CTborg-robot/ROS-CTborg/README.md

# ROS-CTborg
Добрый день уважаемые читатели. 
мы создали робота который состоит из модулей
и настраивается под конкретные ваши задачи
в данной модели мы показываем модуль для
работы с плохо видящими людьми
"CTborg поводырь" который отслеживает препятствия
и объясняет человеку как его обойти.
