CTborg-robot/ROS-CTborg/Список компонентов ROS CTborg.xlsx

Категория | Наименование компонента | Назначение, описание | Ссылка | Количество | Цена |  |  | Итоговая сумма | Примерные сроки доставки
 |  |  |  |  | Цена | Доставка | Итого за штуку
Плата | Плата Raspberry Pi 5 8 ГБ Ram Arm Cortex-A76 Linux | Raspberry pi 5 8gb - это новый и усовершенствованный одноплатный компьютер, идеально подходящий для различных проектов. Этот микрокомпьютер обладает высокой производительностью и множеством улучшений по сравнению с предыдущей версией. | https://aliexpress.ru/item/1005002515949841.html?ysclid=m93stthbfn91280838&sku_id=12000020961528705 | 1 | 9236 | 346 | 9582 | 9582 | 15 дней
Модуль | ESP32 ESP-WROOM-32 | Мощный, универсальный Модуль MCU Wi-Fi + BT + BLE, предназначенный для широкого спектра приложений, Начиная от маломощных сенсорных сетей до самых сложных задач, таких как Как кодирование голоса, потоковая передача музыки и декодирование MP3 | https://aliexpress.ru/item/1005002515949841.html?ysclid=m93stthbfn91280838&sku_id=12000020961528705 | 1 | 319 | 83 | 402 | 402 | 15 дней
Мотор | JGB37-520 | Мотор-редуктор 6 В 12 В 24 В постоянного тока с энкодером и комплектом колес для DIY | https://aliexpress.ru/popular/jgb37-520?g=y&page=1 | 2 | 719 | 596 | 1315 | 2630 | 16 дней
Модуль драйвера | L298N | Новый Модуль платы контроллера привода шагового двигателя постоянного тока Dual H Bridge L298N | https://aliexpress.ru/item/1005003249965238.html?sku_id=12000024855179600 | 1 | 125 | 21 | 146 | 146 | 15 дней
Аккумулятор | VANT Battery | Аккумулятор LiPo Vant - 11.1В 3000мАч 75C (3S, мягкий корпус, разъём XT60) | https://www.ozon.ru/product/akkumulyator-lipo-vant-11-1v-3000mach-75c-3s-myagkiy-korpus-razem-xt60-1710436775/ | 1 | 2027 | 0 | 2027 | 2027 | 1-2 дня
Лидар | LiDAR для Dreame D9 F9 D9 Pro D9 Plus L10 Pro W10 | Технология дистанционного зондирования, которая использует лазерные лучи для измерения точных расстояний и движения в окружающей среде в режиме реального времени | https://aliexpress.ru/item/1005007149385720.html?sku_id=12000039595834626&tt=MG | 1 | 1622 | 0 | 1622 | 1622 | 12 дней
Кнопки включенния | Тумблер выключатель GSMIN KCD11 ON-OFF 3А 250В AC 2pin (15x10) | Тумблер выключатель GSMIN KCD11 ON-OFF 3А 250В AC 2pin (15x10) | https://www.ozon.ru/product/tumbler-vyklyuchatel-gsmin-kcd11-on-off-3a-250v-ac-2pin-15x10-25sht-chernyy-1074309699/ | 1 | 313 | 0 | 313 | 313 | 1-2 дня
Провода | Провода-перемычки Dupont 20 см 3 вида по 40 шт | Соединительные провода Male-Female 40шт разноцветные 20 см Соединительные провода Female-Female 40шт разноцветные 20 см Соединительные провода Male-Male 40шт разноцветные 20 см | https://www.ozon.ru/product/120-sht-provoda-peremychki-dupont-20-sm-3-vida-po-40-sht-mama-mama-papa-papa-papa-mama-dlya-arduino-1894946009/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 (https://aliexpress.ru/item/1005002490065496.html?pdp_trigger_item_id=0_32481062593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) | 1 | 460 | 0 | 460 | 460 | 1-2 дня
Мебельные ролики | Мебельные ролики 4 шт., черные, из пластика и стали | Опоры, которые позволяют перемещать мебель в пределах помещения | https://aliexpress.ru/item/1005005906429335.html?sku_id=12000034793267875 | 1 | 240 | 0 | 240 | 240 | 12 дней
Камера | DEXP Web-камера | DEXP Web-камера с микрофоном Chat M100R1 | https://www.ozon.ru/product/dexp-web-kamera-s-mikrofonom-chat-m100r1-chernyy-1413742756/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 | 1 | 4451 | 0 | 4451 | 4451 | 5-10 дней
Пластик | ПЛА пластик для 3д печтати PLA для 3D принтера Element 3D | ПЛА пластик для 3д печтати PLA для 3D принтера Element 3D | https://www.ozon.ru/product/pla-plastik-dlya-3d-pechtati-pla-dlya-3d-printera-element-3d-1-75mm-1-kg-siniy-1465034333/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 | 1 | 1264 | 0 | 1264 | 1264 | 1-2 дня
Вольтметр-амперметр | Мини-вольтметр-амперметр DC0-100V 50A 100A синий красный | Устройство, которое позволяет измерять напряжение и силу тока в электрических цепях | https://aliexpress.ru/item/1005008017518519.html?sku_id=12000043266493755 | 1 | 123 | 0 | 123 | 123 | 14 дней
 |  |  |  |  |  |  | Сумма всей покупки: | 23260
