CTborg-robot/ROS-CTborg/Электросхема-робота.pdf

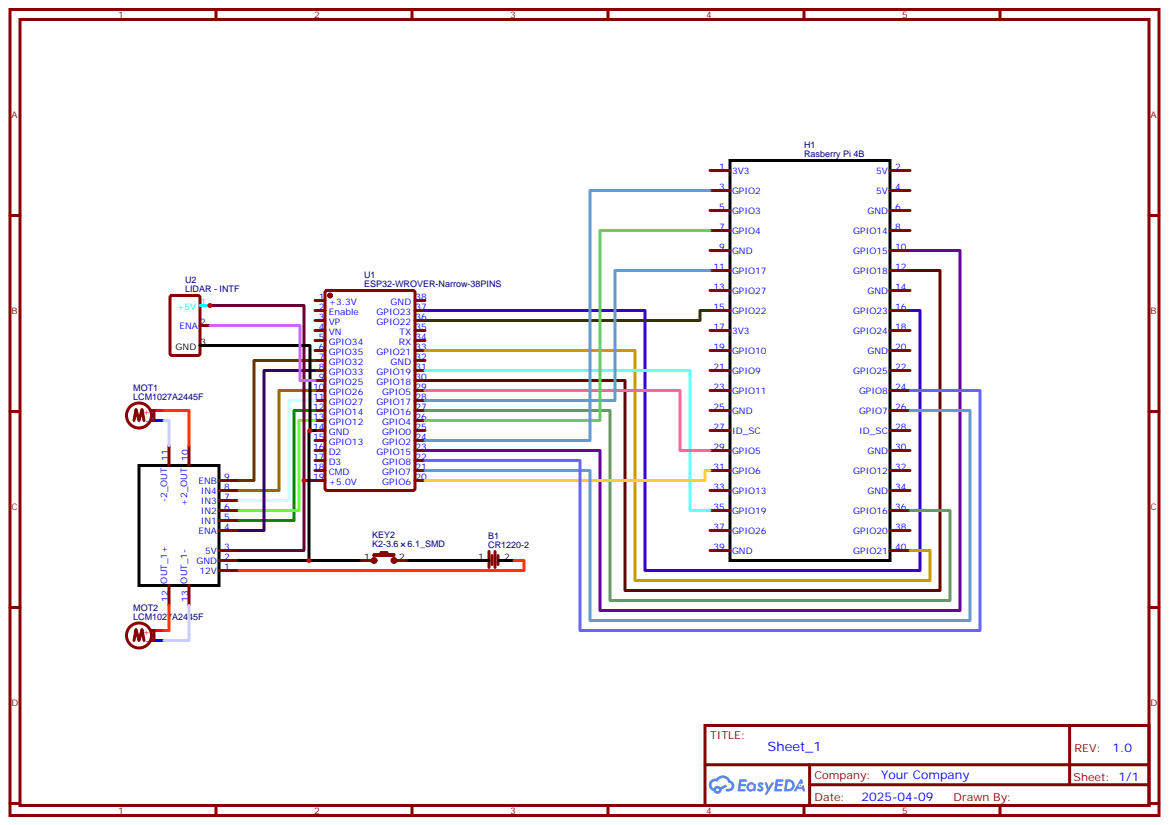
[picture p18: page 1]
